shivamrishi/SPIInterface8085/README.md

# SPIInterface8085

Protocols like SPI and I2C are not supported by 8085 processors without any external peripherals and IC's. 
Therefore, bit-banging is used to communicate with 8085 based system. Addressable latches are used for this purpose. the details can be found in compass.sch.
