shivamrishi/SPIInterface8085/compass.brd

## EAGLE design compass.brd (2018-04-16)

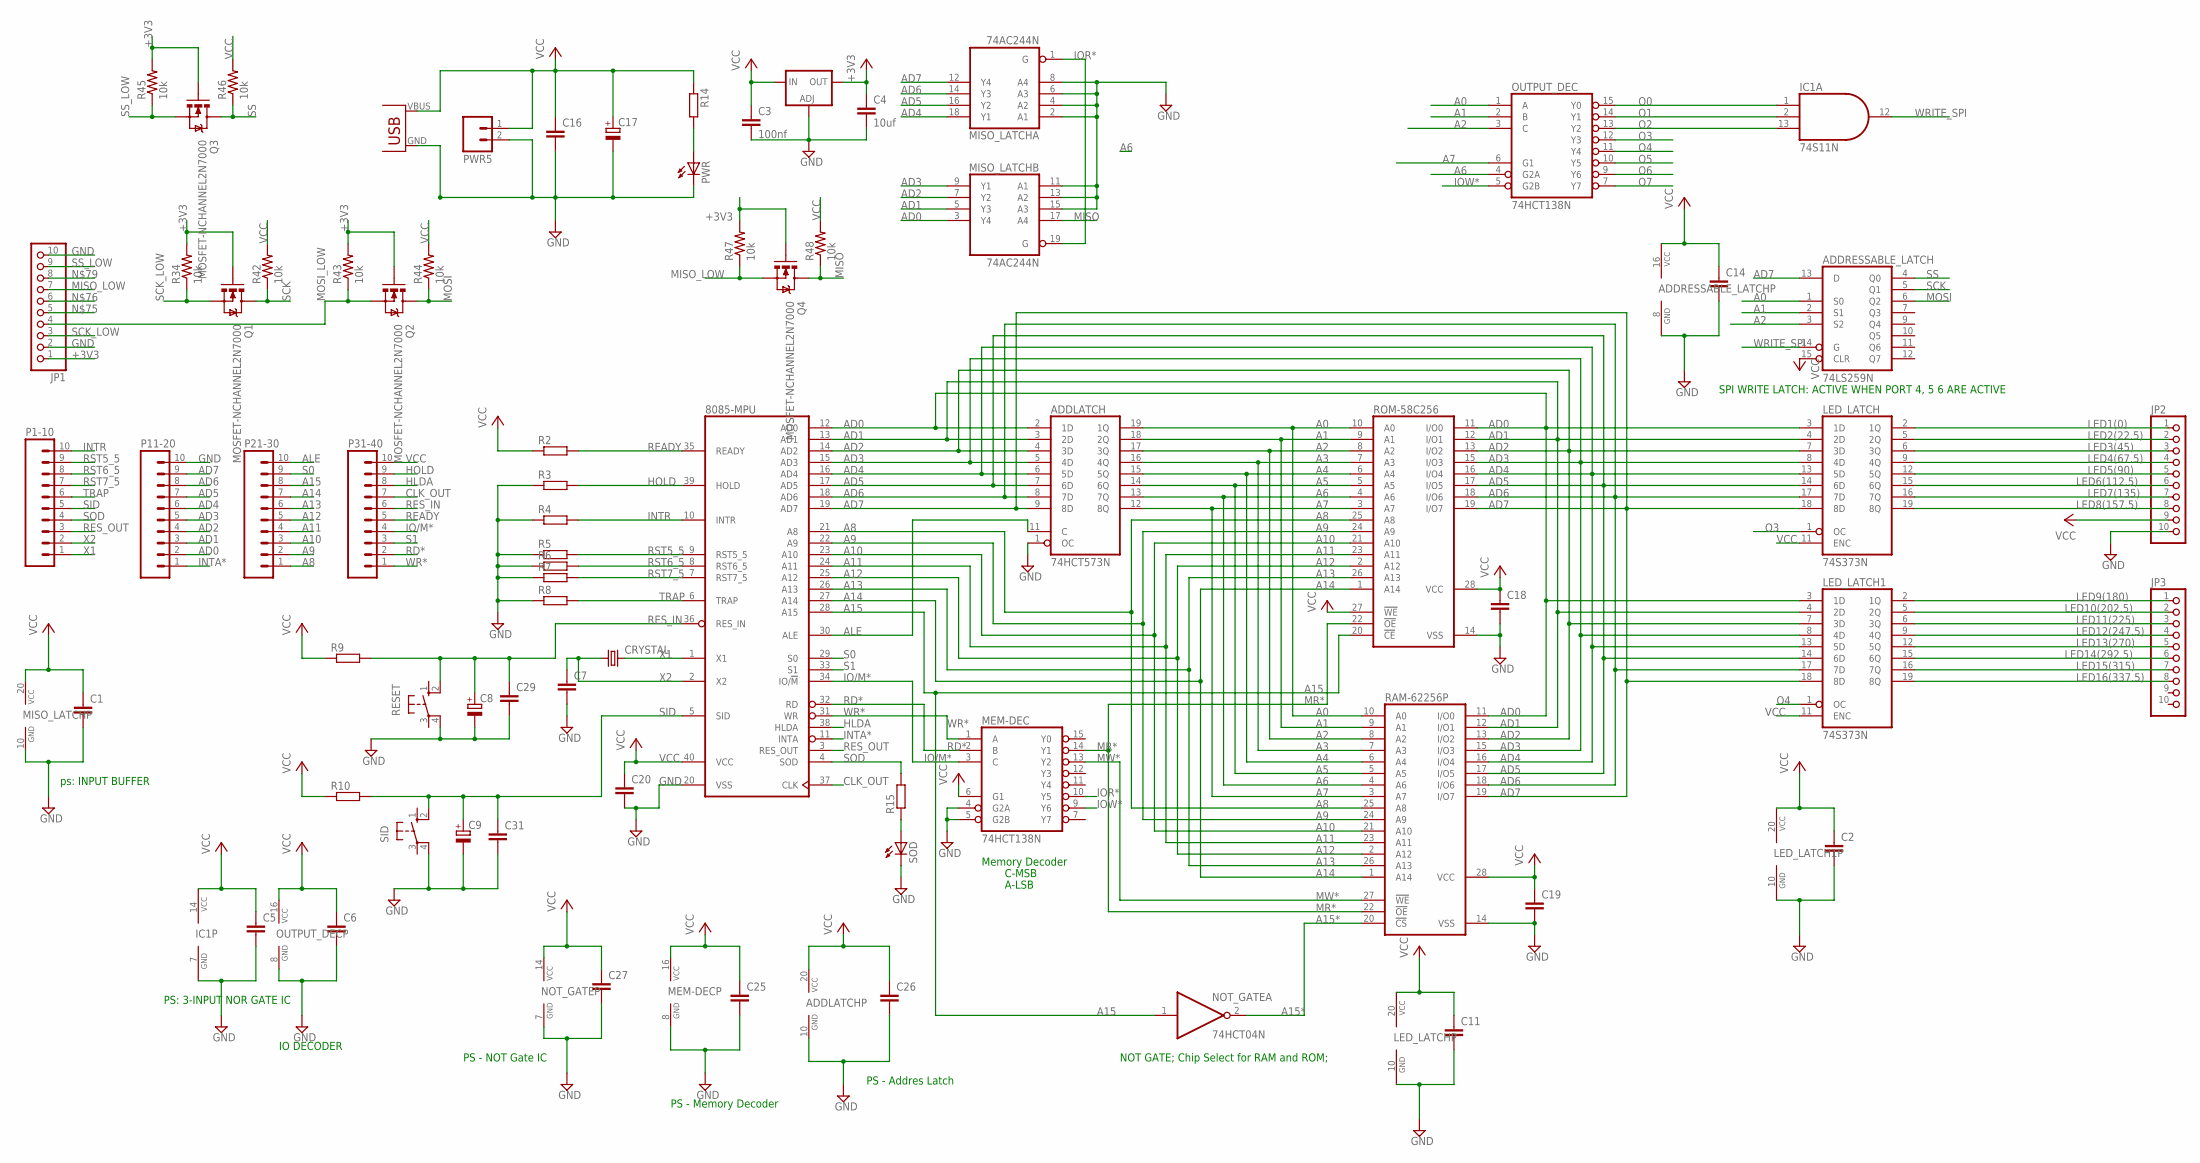
[picture p1: schematic compass.sch]

Parts:
8085-MPU: 8085; DIL40
ADDLATCH: 74HCT573N; DIL20
ADDRESSABLE_LATCH: 74LS259N; DIL16
C1, C2, C5, C6, C7, C11, C14, C16, C18, C19, C20, C25, C26, C27, C29, C31: C-EU025-025X050; C025-025X050
C3: 100nf; C025-025X050
C4: 10uf; C025-025X050
C8, C9, C17: CPOL-EUE2.5-6; E2,5-6
CRYSTAL: CRYSTALHC49US; HC49US
IC1: 74S11N; DIL14
IC10: LD117AS33TR; SOT223
JP1, JP2, JP3: PINHD-1X10; 1X10
LED_LATCH, LED_LATCH1: 74S373N; DIL20
MEM-DEC: 74HCT138N; DIL16
MISO_LATCH: 74AC244N; DIL20
NOT_GATE: 74HCT04N; DIL14
OUTPUT_DEC: 74HCT138N; DIL16
P1-10, P11-20, P21-30, P31-40: M10; 10P
PWR: LED5MM
PWR5: M02; 02P
Q1, Q2, Q3, Q4: MOSFET-NCHANNEL2N7000; TO-92
R2, R3, R4, R5, R6, R7, R8, R9, R10, R14, R15: R-EU_0204/7; 0204/7
R34, R42, R43, R44, R45, R46, R47, R48: 10k; 0204/7
RAM-62256P: 62256P; DIL28-6
RESET: 10-XX; B3F-10XX
ROM-58C256: 58C256P; DIL28-6
SID: 10-XX; B3F-10XX
SOD: LED5MM
USB: USB(POWER)

Connections:
+3V3: C4.1, IC10.4 (OUT), JP1.1, Q1.2 (G), Q2.2 (G), Q3.2 (G), Q4.2 (G), R34.2, R43.2, R45.2, R47.2
A0: ADDLATCH.19 (1Q), ADDRESSABLE_LATCH.1 (S0), OUTPUT_DEC.1 (A), RAM-62256P.10 (A0), ROM-58C256.10 (A0)
A1: ADDLATCH.18 (2Q), ADDRESSABLE_LATCH.2 (S1), OUTPUT_DEC.2 (B), RAM-62256P.9 (A1), ROM-58C256.9 (A1)
A2: ADDLATCH.17 (3Q), ADDRESSABLE_LATCH.3 (S2), OUTPUT_DEC.3 (C), RAM-62256P.8 (A2), ROM-58C256.8 (A2)
A3: ADDLATCH.16 (4Q), RAM-62256P.7 (A3), ROM-58C256.7 (A3)
A4: ADDLATCH.15 (5Q), RAM-62256P.6 (A4), ROM-58C256.6 (A4)
A5: ADDLATCH.14 (6Q), RAM-62256P.5 (A5), ROM-58C256.5 (A5)
A6: ADDLATCH.13 (7Q), OUTPUT_DEC.4 (G2A), RAM-62256P.4 (A6), ROM-58C256.4 (A6)
A7: ADDLATCH.12 (8Q), OUTPUT_DEC.6 (G1), RAM-62256P.3 (A7), ROM-58C256.3 (A7)
A8: 8085-MPU.21 (A8), P21-30.1, RAM-62256P.25 (A8), ROM-58C256.25 (A8)
A9: 8085-MPU.22 (A9), P21-30.2, RAM-62256P.24 (A9), ROM-58C256.24 (A9)
A10: 8085-MPU.23 (A10), P21-30.3, RAM-62256P.21 (A10), ROM-58C256.21 (A10)
A11: 8085-MPU.24 (A11), P21-30.4, RAM-62256P.23 (A11), ROM-58C256.23 (A11)
A12: 8085-MPU.25 (A12), P21-30.5, RAM-62256P.2 (A12), ROM-58C256.2 (A12)
A13: 8085-MPU.26 (A13), P21-30.6, RAM-62256P.26 (A13), ROM-58C256.26 (A13)
A14: 8085-MPU.27 (A14), P21-30.7, RAM-62256P.1 (A14), ROM-58C256.1 (A14)
A15: 8085-MPU.28 (A15), NOT_GATE.1 (I), P21-30.8, ROM-58C256.20 (!CE)
A15*: NOT_GATE.2 (O), RAM-62256P.20 (!CS)
AD0: 8085-MPU.12 (AD0), ADDLATCH.2 (1D), LED_LATCH.3 (1D), LED_LATCH1.3 (1D), MISO_LATCH.3 (Y4), P11-20.2, RAM-62256P.11 (I/O0), ROM-58C256.11 (I/O0)
AD1: 8085-MPU.13 (AD1), ADDLATCH.3 (2D), LED_LATCH.4 (2D), LED_LATCH1.4 (2D), MISO_LATCH.5 (Y3), P11-20.3, RAM-62256P.12 (I/O1), ROM-58C256.12 (I/O1)
AD2: 8085-MPU.14 (AD2), ADDLATCH.4 (3D), LED_LATCH.7 (3D), LED_LATCH1.7 (3D), MISO_LATCH.7 (Y2), P11-20.4, RAM-62256P.13 (I/O2), ROM-58C256.13 (I/O2)
AD3: 8085-MPU.15 (AD3), ADDLATCH.5 (4D), LED_LATCH.8 (4D), LED_LATCH1.8 (4D), MISO_LATCH.9 (Y1), P11-20.5, RAM-62256P.15 (I/O3), ROM-58C256.15 (I/O3)
AD4: 8085-MPU.16 (AD4), ADDLATCH.6 (5D), LED_LATCH.13 (5D), LED_LATCH1.13 (5D), MISO_LATCH.18 (Y1), P11-20.6, RAM-62256P.16 (I/O4), ROM-58C256.16 (I/O4)
AD5: 8085-MPU.17 (AD5), ADDLATCH.7 (6D), LED_LATCH.14 (6D), LED_LATCH1.14 (6D), MISO_LATCH.16 (Y2), P11-20.7, RAM-62256P.17 (I/O5), ROM-58C256.17 (I/O5)
AD6: 8085-MPU.18 (AD6), ADDLATCH.8 (7D), LED_LATCH.17 (7D), LED_LATCH1.17 (7D), MISO_LATCH.14 (Y3), P11-20.8, RAM-62256P.18 (I/O6), ROM-58C256.18 (I/O6)
AD7: 8085-MPU.19 (AD7), ADDLATCH.9 (8D), ADDRESSABLE_LATCH.13 (D), LED_LATCH.18 (8D), LED_LATCH1.18 (8D), MISO_LATCH.12 (Y4), P11-20.9, RAM-62256P.19 (I/O7), ROM-58C256.19 (I/O7)
ALE: 8085-MPU.30 (ALE), ADDLATCH.11 (C), P21-30.10
CLK_OUT: 8085-MPU.37 (CLK), P31-40.7
GND: 8085-MPU.20 (VSS), ADDLATCH.1 (OC), ADDLATCH.10 (GND), ADDRESSABLE_LATCH.8 (GND), C1.2, C2.2, C3.2, C4.2, C5.2, C6.2, C7.2, C8.-, C9.-, C11.2, C14.2, C16.2, C17.-, C18.2, C19.2, C20.2, C25.2, C26.2, C27.2, C29.2, C31.2, IC1.7 (GND), IC10.1 (ADJ), JP1.2, JP1.10, JP2.10, LED_LATCH.10 (GND), LED_LATCH1.10 (GND), MEM-DEC.4 (G2A), MEM-DEC.5 (G2B), MEM-DEC.8 (GND), MISO_LATCH.2 (A1), MISO_LATCH.4 (A2), MISO_LATCH.6 (A3), MISO_LATCH.8 (A4), MISO_LATCH.10 (GND), MISO_LATCH.11 (A1), MISO_LATCH.13 (A2), MISO_LATCH.15 (A3), NOT_GATE.7 (GND), OUTPUT_DEC.8 (GND), P11-20.10, PWR.K (C), PWR5.2, R3.1, R4.1, R5.1, R6.1, R7.1, R8.1, RAM-62256P.14 (VSS), RESET.4 (P1), ROM-58C256.14 (VSS), SID.4 (P1), SOD.K (C), USB.GND
HLDA: 8085-MPU.38 (HLDA), P31-40.8
HOLD: 8085-MPU.39 (HOLD), P31-40.9, R3.2
INTA*: 8085-MPU.11 (INTA), P11-20.1
INTR: 8085-MPU.10 (INTR), P1-10.10, R4.2
IO/M*: 8085-MPU.34 (IO/!M), MEM-DEC.3 (C), P31-40.4
IOR*: MEM-DEC.10 (Y5), MISO_LATCH.1 (G), MISO_LATCH.19 (G)
IOW*: MEM-DEC.9 (Y6), OUTPUT_DEC.5 (G2B)
LED1(0): JP2.1, LED_LATCH.2 (1Q)
LED2(22.5): JP2.2, LED_LATCH.5 (2Q)
LED3(45): JP2.3, LED_LATCH.6 (3Q)
LED4(67.5): JP2.4, LED_LATCH.9 (4Q)
LED5(90): JP2.5, LED_LATCH.12 (5Q)
LED6(112.5): JP2.6, LED_LATCH.15 (6Q)
LED7(135): JP2.7, LED_LATCH.16 (7Q)
LED8(157.5): JP2.8, LED_LATCH.19 (8Q)
LED9(180): JP3.1, LED_LATCH1.2 (1Q)
LED10(202.5): JP3.2, LED_LATCH1.5 (2Q)
LED11(225): JP3.3, LED_LATCH1.6 (3Q)
LED12(247.5): JP3.4, LED_LATCH1.9 (4Q)
LED13(270): JP3.5, LED_LATCH1.12 (5Q)
LED14(292.5): JP3.6, LED_LATCH1.15 (6Q)
LED15(315): JP3.7, LED_LATCH1.16 (7Q)
LED16(337.5): JP3.8, LED_LATCH1.19 (8Q)
MISO: MISO_LATCH.17 (A4), Q4.3 (D), R48.1
MISO_LOW: JP1.7, Q4.1 (S), R47.1
MOSI: ADDRESSABLE_LATCH.6 (Q2), Q2.3 (D), R44.1
MOSI_LOW: JP1.4, Q2.1 (S), R43.1
MR*: MEM-DEC.14 (Y1), RAM-62256P.22 (!OE), ROM-58C256.22 (!OE)
MW*: MEM-DEC.13 (Y2), RAM-62256P.27 (!WE)
unnamed: R15.1, SOD.A
unnamed: PWR.A, R14.2
O0: IC1.1 (I0), OUTPUT_DEC.15 (Y0)
O1: IC1.2 (I1), OUTPUT_DEC.14 (Y1)
O2: IC1.13 (I2), OUTPUT_DEC.13 (Y2)
O3: LED_LATCH.1 (OC), OUTPUT_DEC.12 (Y3)
O4: LED_LATCH1.1 (OC), OUTPUT_DEC.11 (Y4)
O5: OUTPUT_DEC.10 (Y5)
O6: OUTPUT_DEC.9 (Y6)
O7: OUTPUT_DEC.7 (Y7)
RD*: 8085-MPU.32 (RD), MEM-DEC.2 (B), P31-40.2
READY: 8085-MPU.35 (READY), P31-40.5, R2.2
RES_IN: 8085-MPU.36 (RES_IN), C8.+, C29.1, P31-40.6, R9.2, RESET.2 (S1)
RES_OUT: 8085-MPU.3 (RES_OUT), P1-10.3
RST5_5: 8085-MPU.9 (RST5_5), P1-10.9, R5.2
RST6_5: 8085-MPU.8 (RST6_5), P1-10.8, R6.2
RST7_5: 8085-MPU.7 (RST7_5), P1-10.7, R7.2
S0: 8085-MPU.29 (S0), P21-30.9
S1: 8085-MPU.33 (S1), P31-40.3
SCK: ADDRESSABLE_LATCH.5 (Q1), Q1.3 (D), R42.1
SCK_LOW: JP1.3, Q1.1 (S), R34.1
SID: 8085-MPU.5 (SID), C9.+, C31.1, P1-10.5, R10.2, SID.2 (S1)
SOD: 8085-MPU.4 (SOD), P1-10.4, R15.2
SS: ADDRESSABLE_LATCH.4 (Q0), Q3.3 (D), R46.1
SS_LOW: JP1.9, Q3.1 (S), R45.1
TRAP: 8085-MPU.6 (TRAP), P1-10.6, R8.2
VCC: 8085-MPU.40 (VCC), ADDLATCH.20 (VCC), ADDRESSABLE_LATCH.15 (CLR), ADDRESSABLE_LATCH.16 (VCC), C1.1, C2.1, C3.1, C5.1, C6.1, C11.1, C14.1, C16.1, C17.+, C18.1, C19.1, C20.1, C25.1, C26.1, C27.1, IC1.14 (VCC), IC10.3 (IN), JP2.9, LED_LATCH.11 (ENC), LED_LATCH.20 (VCC), LED_LATCH1.11 (ENC), LED_LATCH1.20 (VCC), MEM-DEC.6 (G1), MEM-DEC.16 (VCC), MISO_LATCH.20 (VCC), NOT_GATE.14 (VCC), OUTPUT_DEC.16 (VCC), P31-40.10, PWR5.1, R2.1, R9.1, R10.1, R14.1, R42.2, R44.2, R46.2, R48.2, RAM-62256P.28 (VCC), ROM-58C256.27 (!WE), ROM-58C256.28 (VCC), USB.VBUS (VCC)
WR*: 8085-MPU.31 (WR), MEM-DEC.1 (A), P31-40.1
WRITE_SPI: ADDRESSABLE_LATCH.14 (G), IC1.12 (O)
X1: 8085-MPU.1 (X1), CRYSTAL.2, P1-10.1
X2: 8085-MPU.2 (X2), C7.1, CRYSTAL.1, P1-10.2

Notes on the sheet:
PS - NOT Gate IC
PS - Memory Decoder
PS - Addres Latch
Memory Decoder
C-MSB
A-LSB
NOT GATE; Chip Select for RAM and ROM;
SPI WRITE LATCH: ACTIVE WHEN PORT 4, 5 6 ARE ACTIVE
ps: INPUT BUFFER
PS: 3-INPUT NOR GATE IC
IO DECODER

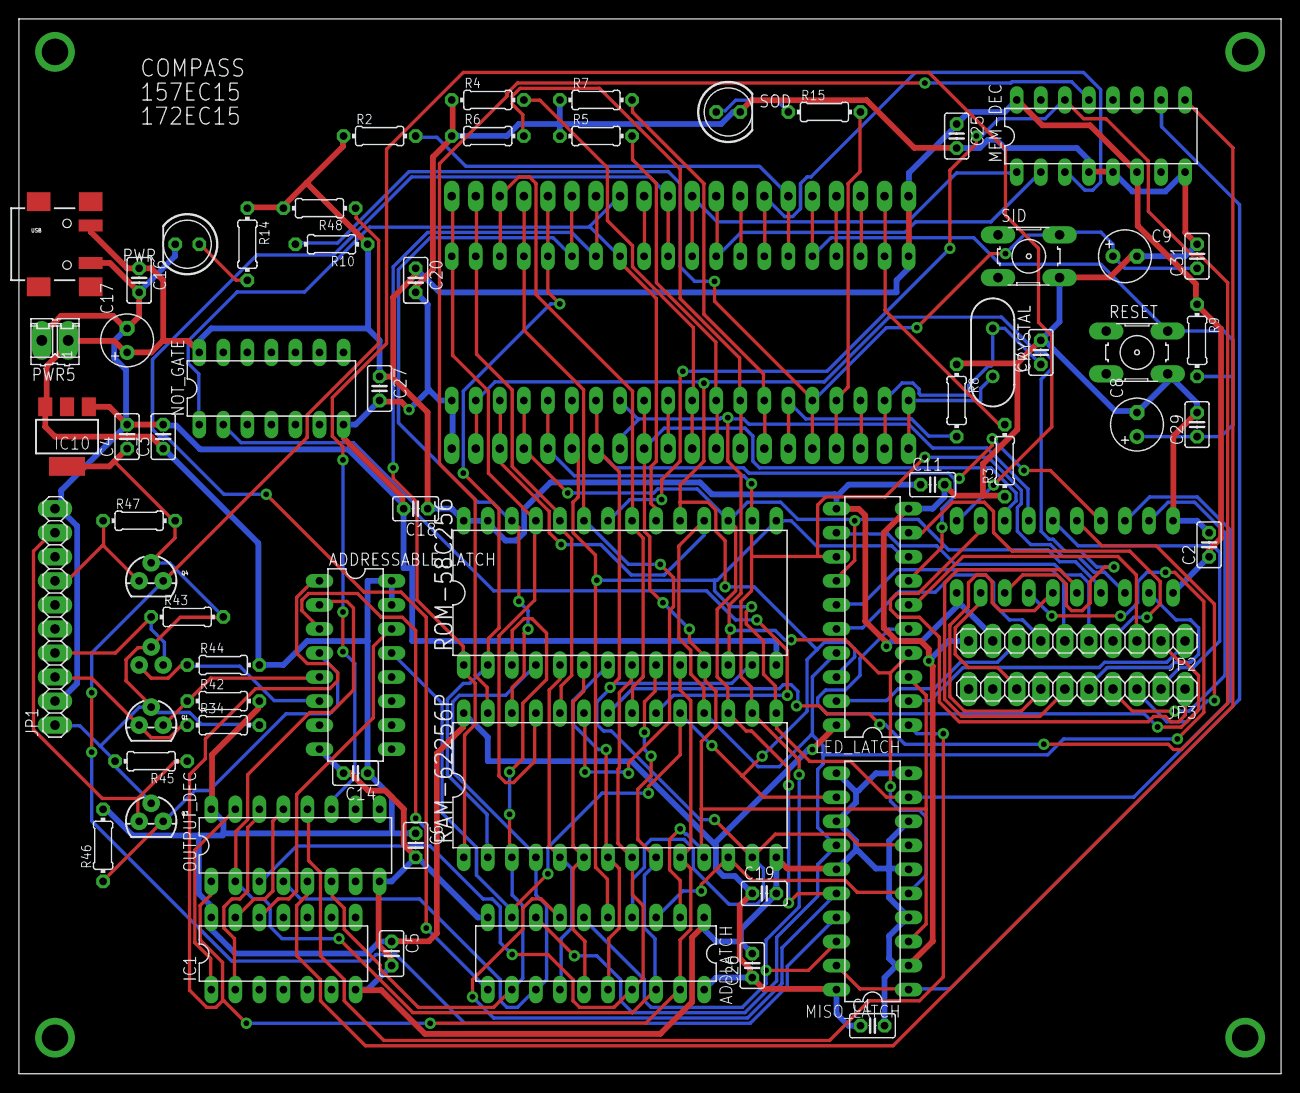
[picture p2: board compass.brd from above]

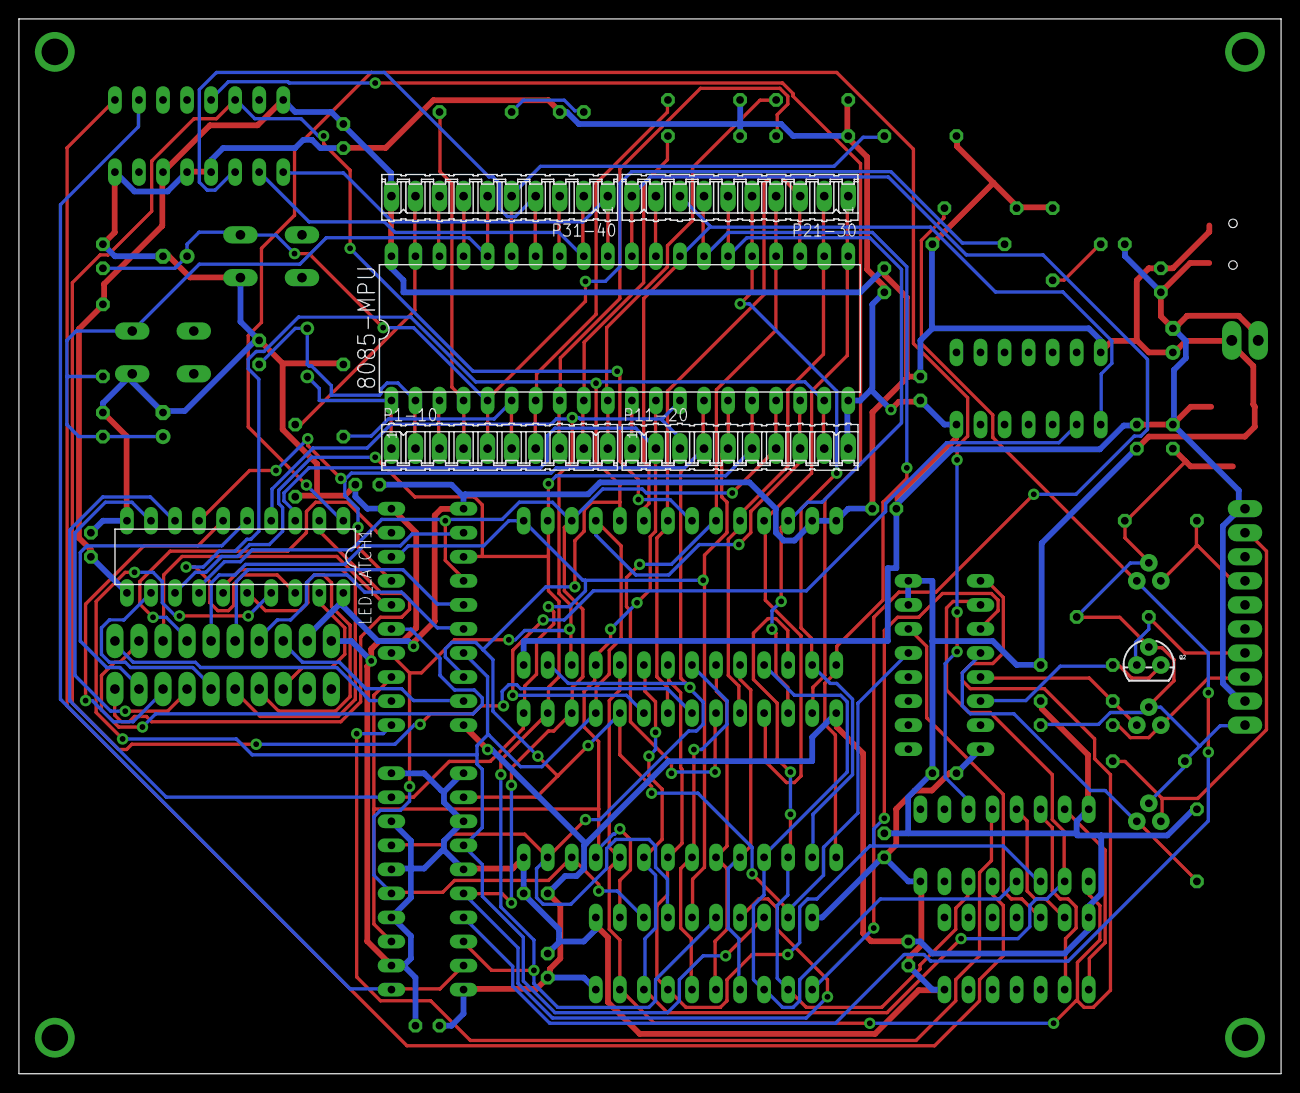
[picture p3: board compass.brd from below]

Board: 2 copper layers, 133.3 x 111.4 mm, 71 parts (7 on the bottom side), 86 nets.
