shivamrishi/SPIInterface8085/MAIN_INPUT_OUTPUT_TESTING.asm

CLOCK:    	MVI A, 80H
	OUT 81H
	CALL SAMPLE_CLOCK
	CALL DELAY
	MVI A, 00H
	OUT 81H
	CALL SAMPLE_CLOCK
	CALL DELAY
	JMP CLOCK
	
SAMPLE_CLOCK:	IN 00H
		RRC
		OUT 82H
		RET
DELAY:
	   MVI B,8D
DELAYLoop:
	   DCR B
	   JNZ DELAYLoop
	   RET
