shivamrishi/SPIInterface8085/(commit log)

2018-04-16 spi test code working
    [compass.brd, compass.sch]
2018-04-17 successful magnetometer intialization
